bixvongoeler/chordian/assets/diagrams/full_system.png

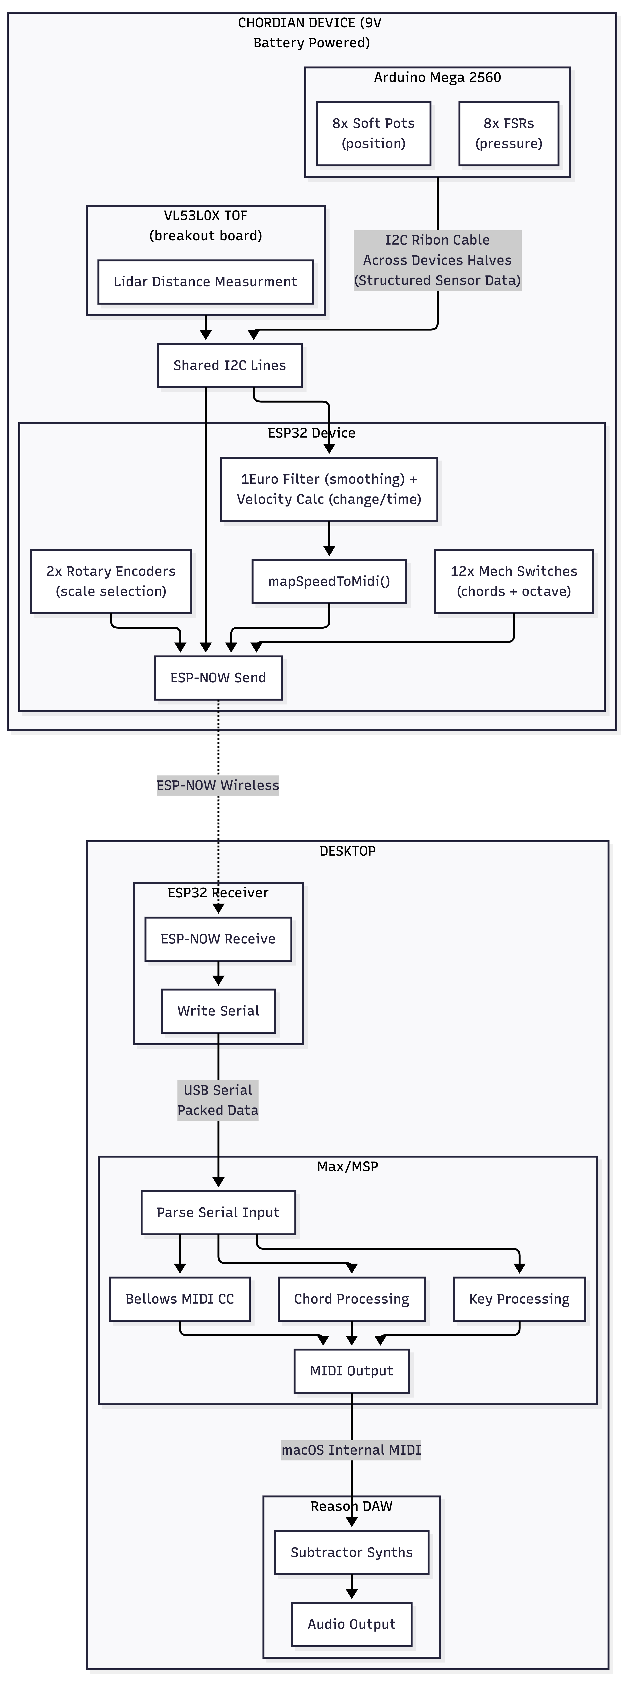
assets/diagrams/full_system.png
