bixvongoeler/chordian/src/max_msp/amplitude_subpatch_screenshot.png

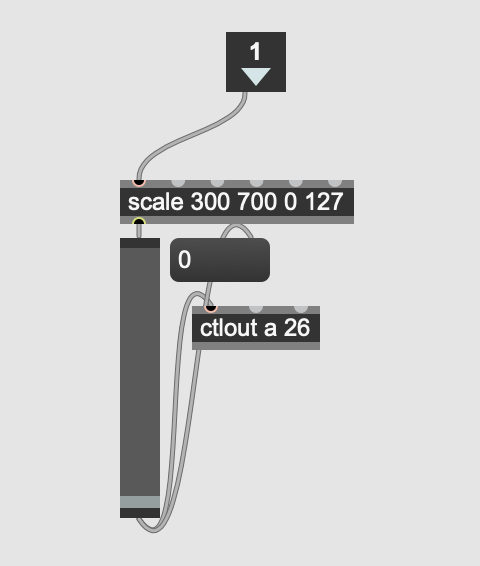
src/max_msp/amplitude_subpatch_screenshot.png
