bixvongoeler/chordian/src/max_msp/chord_subpatch_screenshot.png

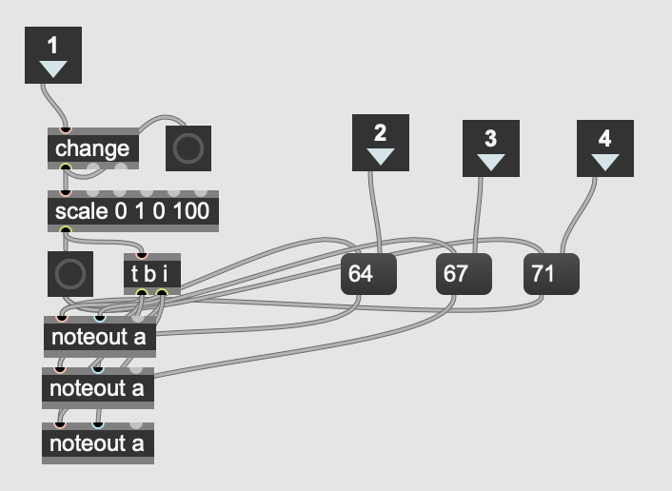
src/max_msp/chord_subpatch_screenshot.png
