bixvongoeler/chordian/src/max_msp/scaler_subpatch_screenshot.png

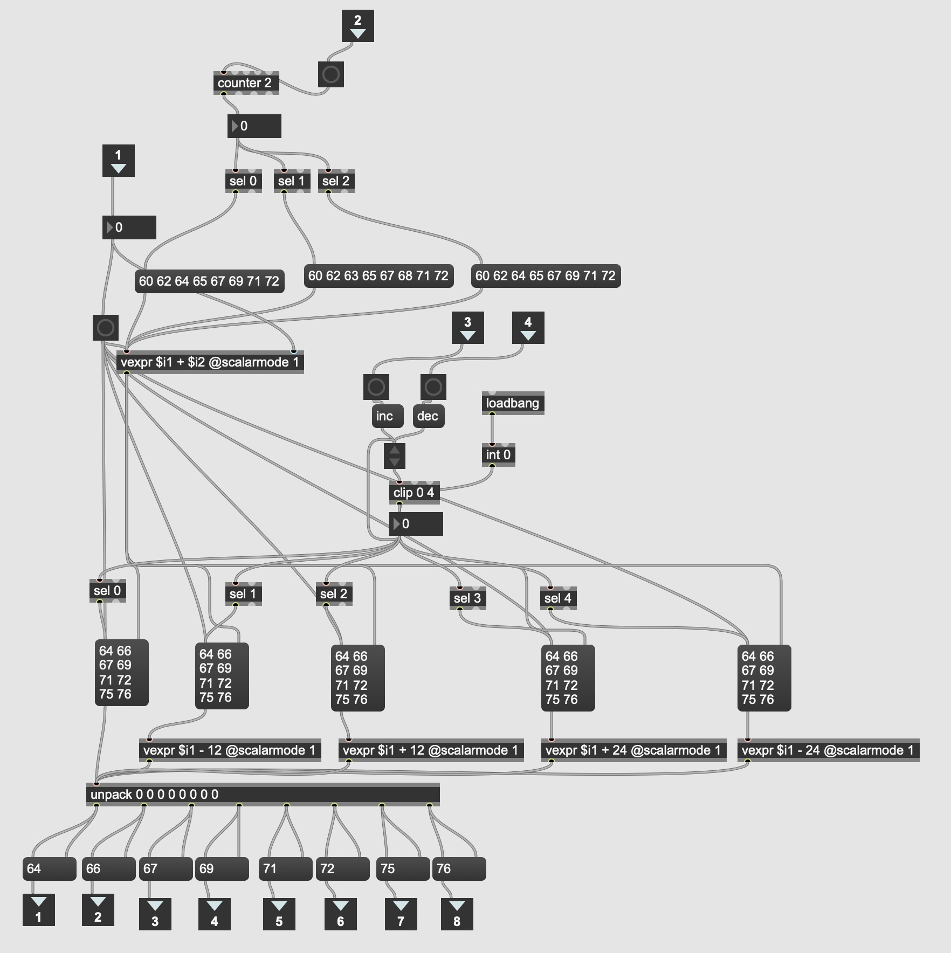
src/max_msp/scaler_subpatch_screenshot.png
