bixvongoeler/chordian/src/max_msp/slider_subpatch_screenshot.png

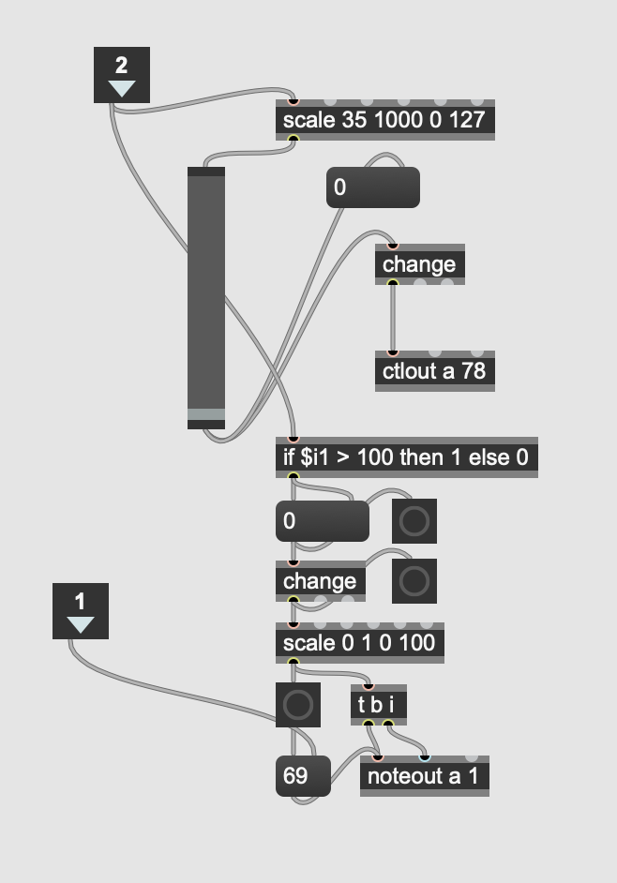
src/max_msp/slider_subpatch_screenshot.png
