bixvongoeler/chordian/photos/assembled_0.jpeg

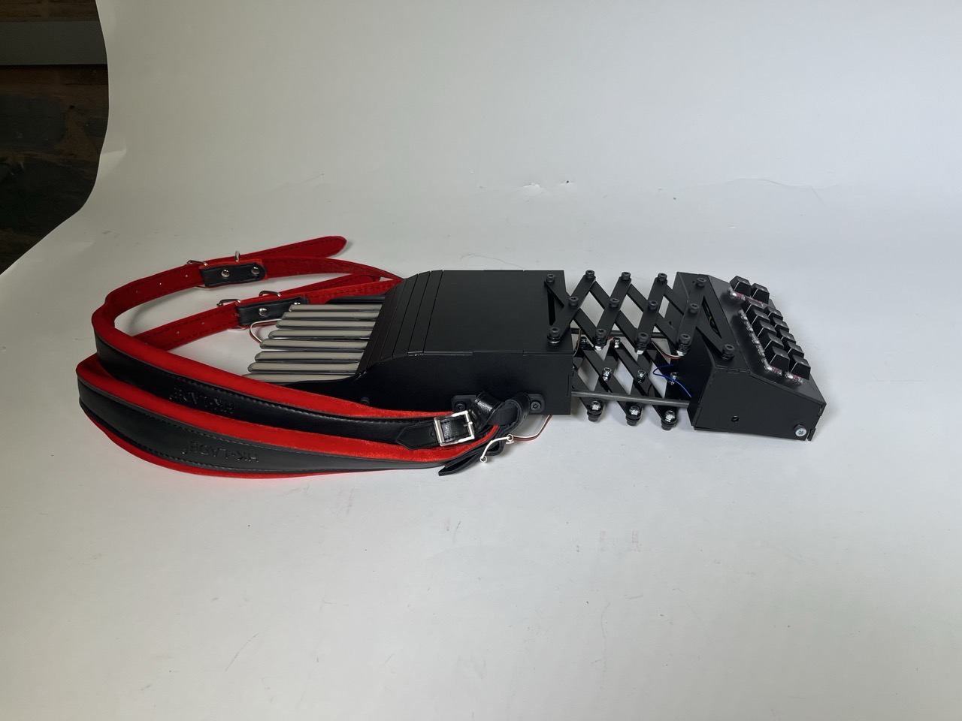
photos/assembled_0.jpeg
