bixvongoeler/chordian/photos/assembled_1.jpeg

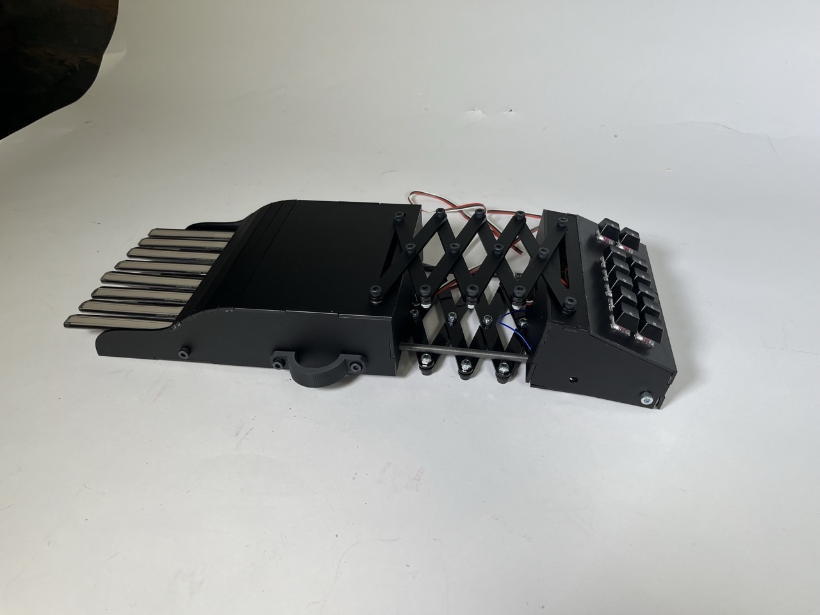
photos/assembled_1.jpeg
