bixvongoeler/chordian/photos/assembled_2.jpeg

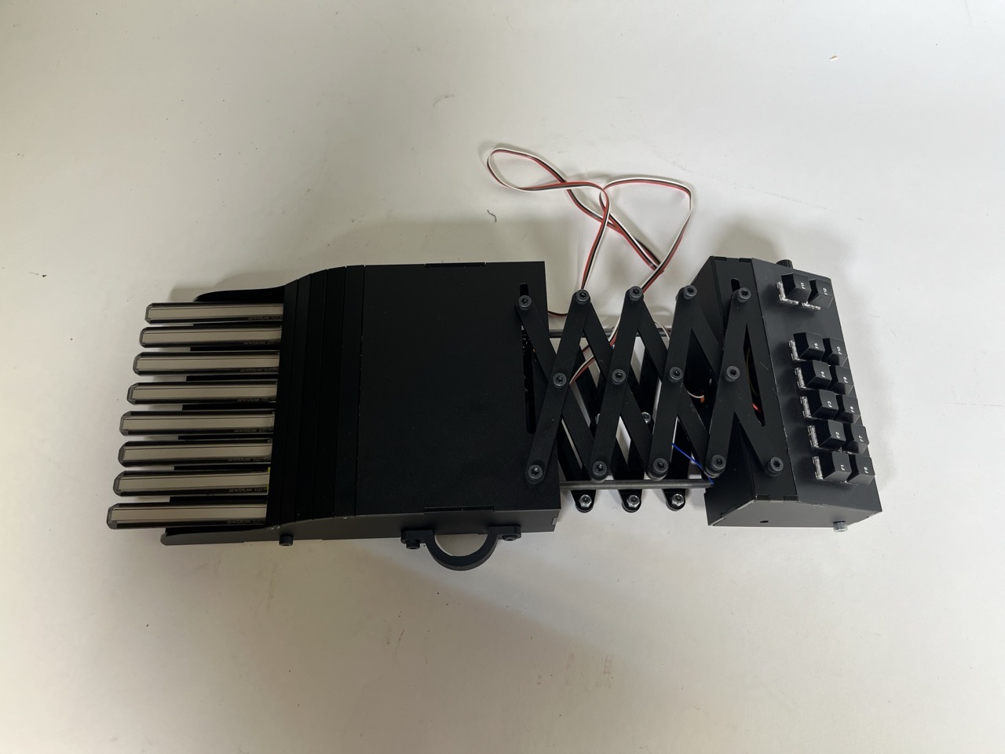
photos/assembled_2.jpeg
