bixvongoeler/chordian/photos/assembled_3.jpeg

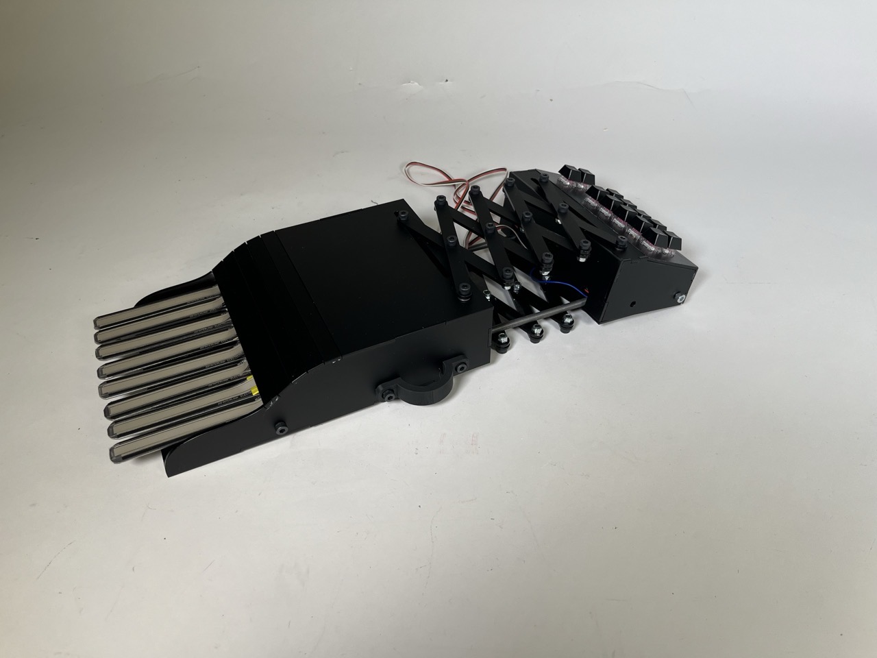
photos/assembled_3.jpeg
