bixvongoeler/chordian/photos/assembled_4.jpeg

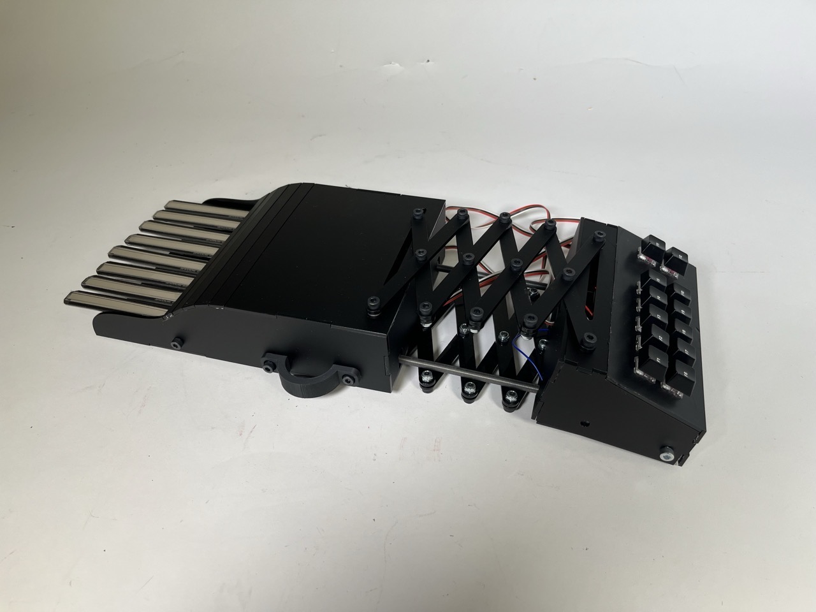
photos/assembled_4.jpeg
