bixvongoeler/chordian/photos/construction_0.JPG

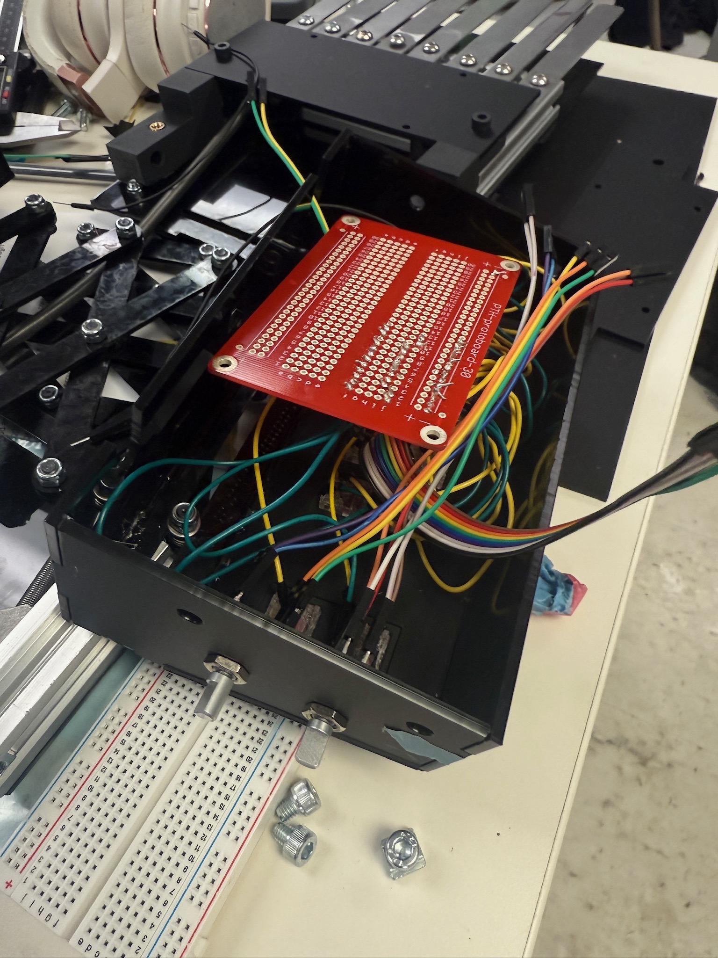
photos/construction_0.JPG
