bixvongoeler/chordian/photos/construction_1.JPG

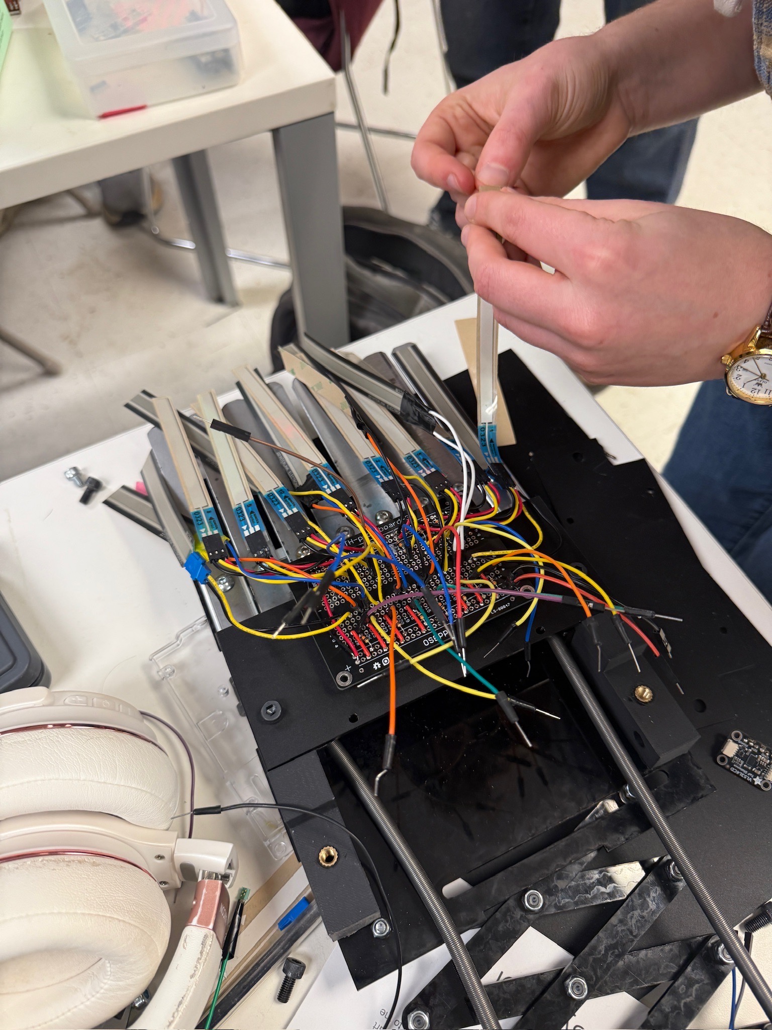
photos/construction_1.JPG
