bixvongoeler/chordian/photos/construction_2.JPG

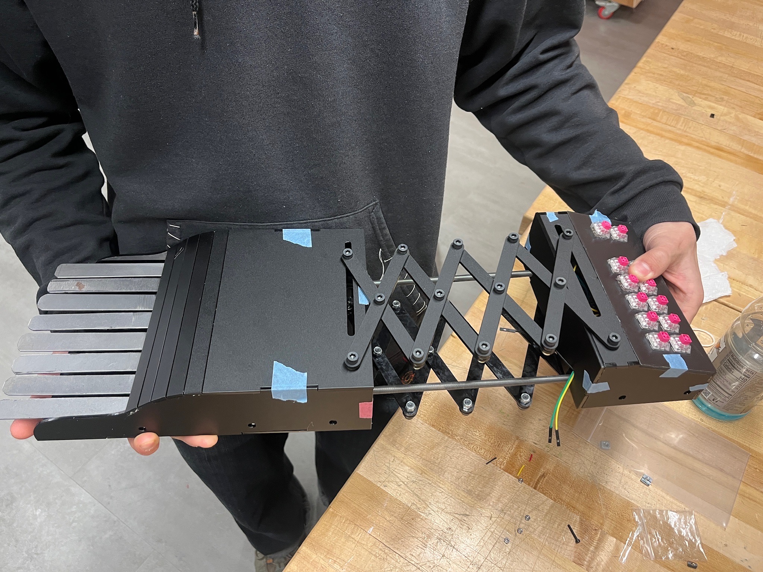
photos/construction_2.JPG
