bixvongoeler/chordian/photos/construction_4.JPG

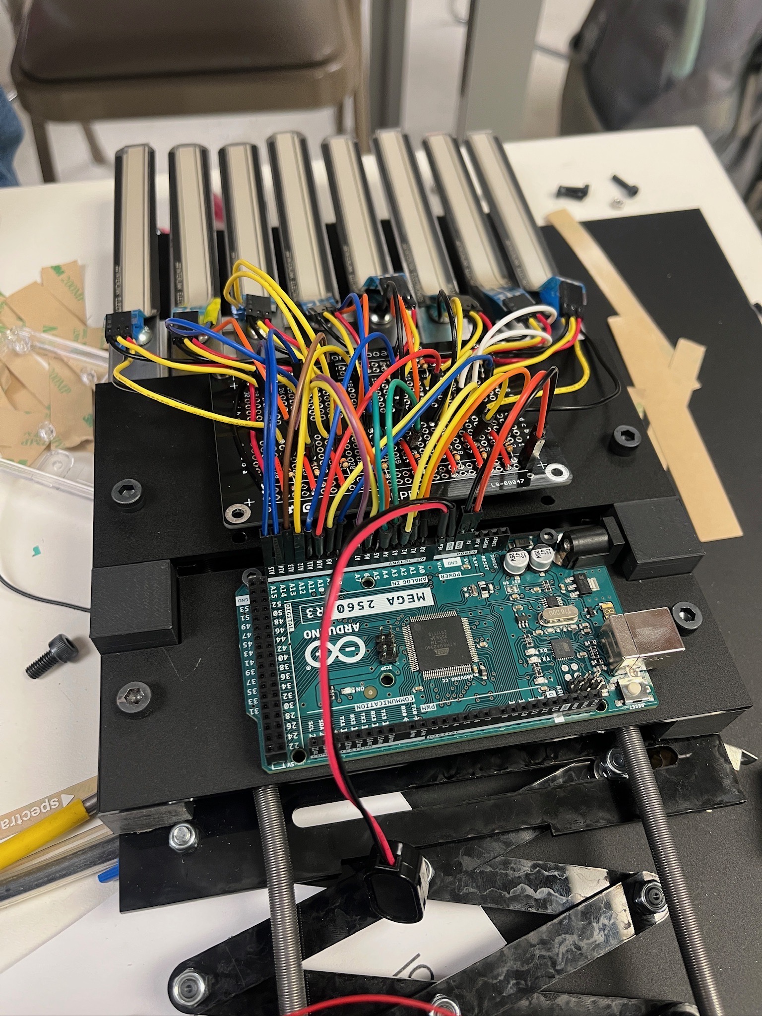
photos/construction_4.JPG
