bixvongoeler/chordian/photos/construction_5.JPG

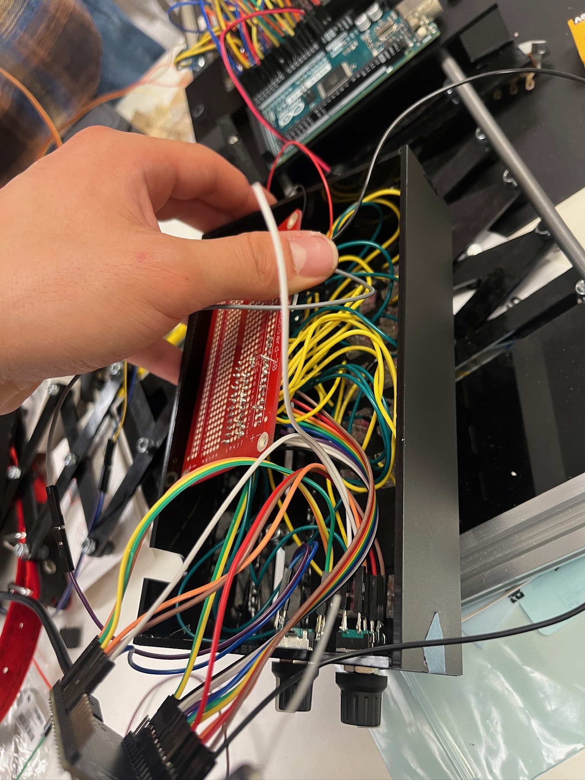
photos/construction_5.JPG
