bixvongoeler/chordian/photos/construction_6.JPG

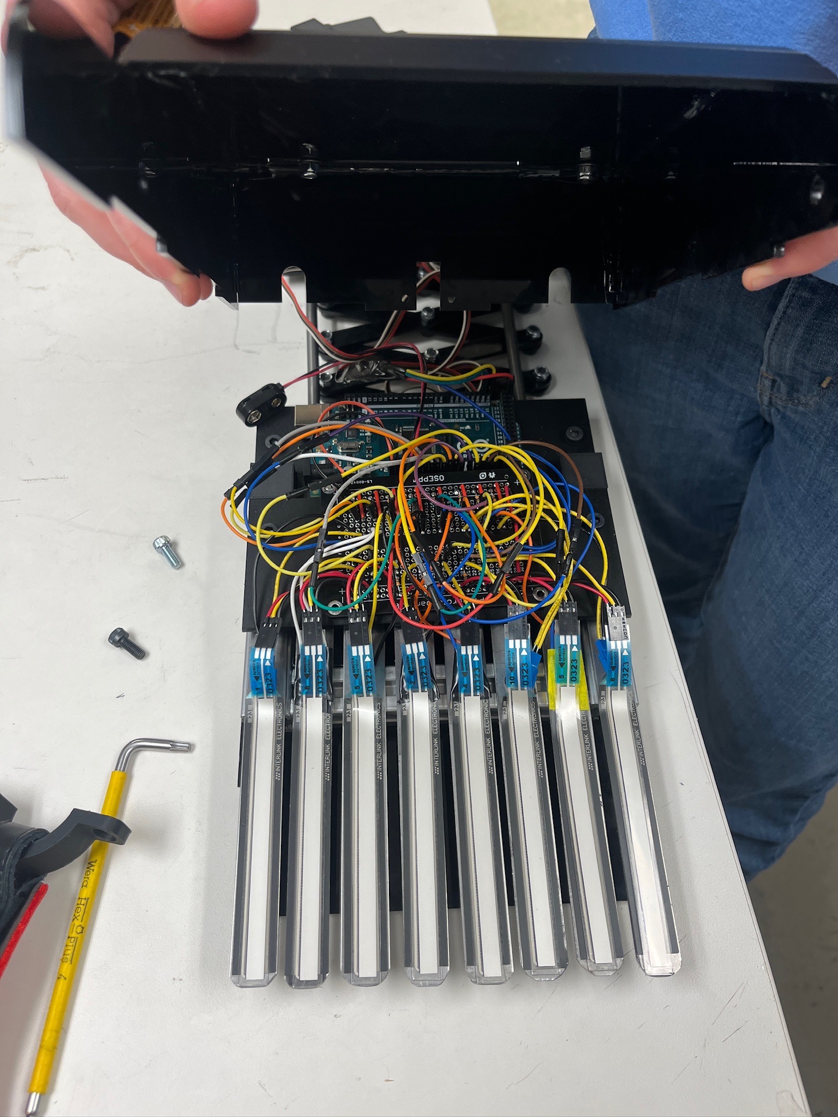
photos/construction_6.JPG
