bixvongoeler/chordian/photos/construction_7.jpeg

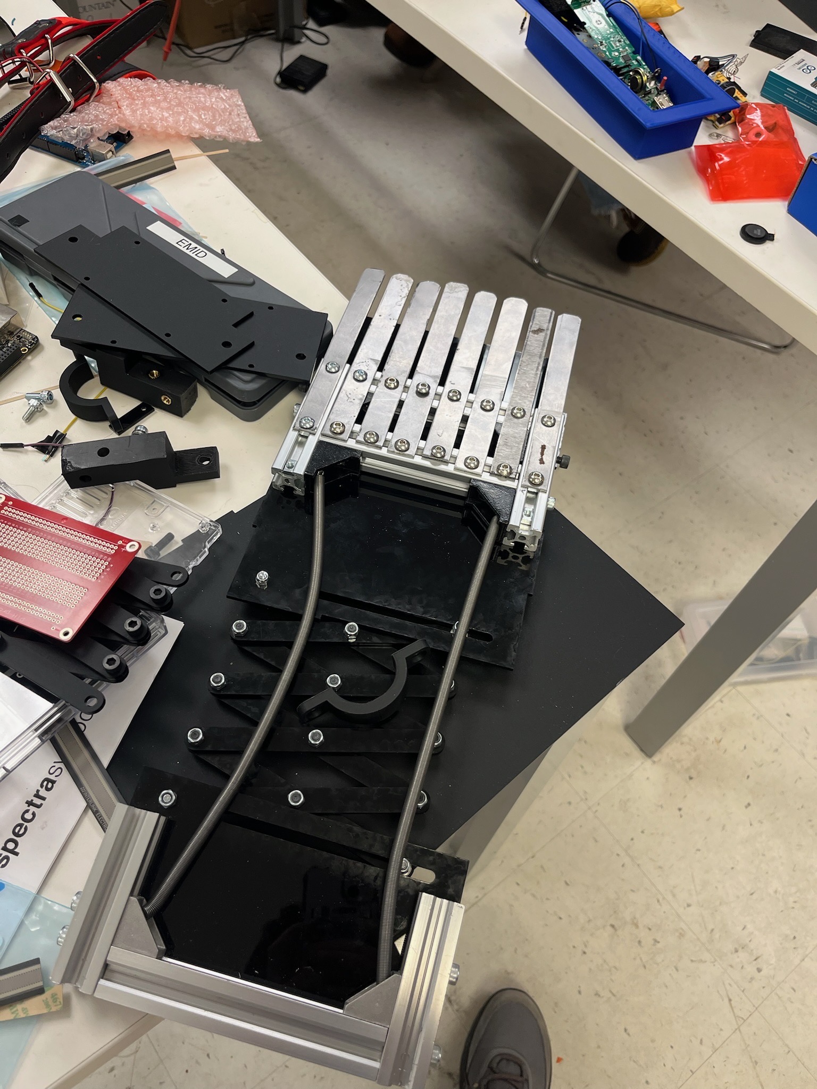
photos/construction_7.jpeg
