bixvongoeler/chordian/photos/construction_8.jpeg

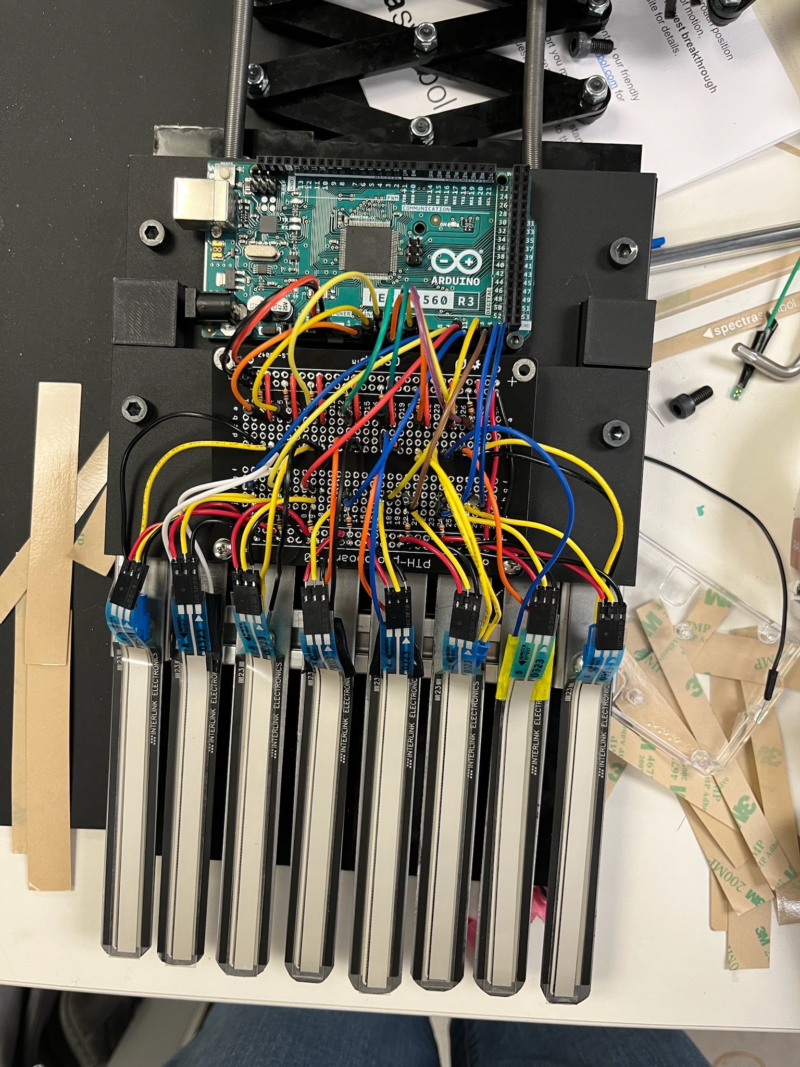
photos/construction_8.jpeg
